janelia-kicad/janelia-kicad-library/README.md

- [Repository Info](#org6b0c83f)
- [Development](#orgdbef2e6)

    <!-- This file is generated automatically from metadata -->
    <!-- File edits may be overwritten! -->

# Repository Info

-   Project Name: janelia-kicad-library
-   Synopsis: Janelia KiCad content library for symbols, footprints, and 3dmodels.
-   Documentation Version: 1.0.0
-   Release Date: 2025-05-16
-   Creation Date: 2023-02-22
-   Kicad Version: 9.0.0
-   License: BSD-3-Clause
-   URL: <https://github.com/janelia-kicad/janelia-kicad-library>
-   Author: Peter Polidoro
-   Email: peter@polidoro.io
-   Copyright: 2025 Howard Hughes Medical Institute
-   References:
    -   [KiCad Library Conventions](https://klc.kicad.org/)

# Development

## Install Guix

[Install Guix](https://guix.gnu.org/manual/en/html_node/Binary-Installation.html)

## Edit metadata.org

    make metadata-edits

## Tangle metadata.org

    make metadata

## Edit project

    make kicad-edits
    exit
