janelia-kicad/janelia-kicad-library/(commit log)

2023-02-22 Add initial symbols and footprints
2023-02-24 Add USB_C connector
2023-02-27 Add OPT101P with various footprints
2023-02-28 Add SMA connector and DIP socket
2023-03-01 Update naming to match KiCad repositories
2023-03-02 Add OPT101 socket
2023-03-07 Add BRIGHT led and photodiode
2023-03-08 Add some capacitors and transimpedence amplifiers
2023-03-10 Add mosfet and capacitor
2023-03-13 Changed resistor values from R_X_PACKAGE to X
2023-03-13 Add optional UMC ground pad
2023-03-15 Add potentiometer and resistors
2023-03-16 Adjust symbols and footprints for wingbeat detector
2023-03-16 Update courtyards for some footprints
2023-03-20 Add back courtyard to MOUNTING_HOLE_2
2023-03-21 Adjust silkscreen text
2023-03-22 Adjust fab layers of footprints
2023-03-23 Adjustments to footprint fab layers
2023-03-30 Add MOUNTING_HOLE_3
2023-03-31 Increase pad size to meet minimum solder paste dimensions
2023-04-03 Add hdmi connector
2023-04-04 Add HDMI_Vertical_SMD schematic symbol
2023-04-04 Add screw term
2023-04-06 Add 20 pin FFC connector
2023-04-13 Modify schematic symbols
2023-04-13 Put voltage in capacitor names
2023-04-13 Add switch debounce IC
2023-04-14 Add resistor footprints and models
2023-04-14 Add 3.3V reg
2023-05-01 Add RS485 driver footprint and 3D model
2023-05-03 Add high current mosfets
2023-05-04 Add high power mosfets
2023-05-05 Add 10uF 35V 0603
2023-05-15 Add FFC 1mm pitch connector
2023-05-18 Add power jack 3D model
2023-05-24 Add Teensy 4.1 step
2023-05-25 Add TEENSY_4.1_FCStd
2023-05-25 Transform Teensy
2023-05-31 Add teensy 4.1 with headers
2023-05-31 Adjust Teensy 4.1 footprint
2023-06-01 Add current supply components
2023-06-05 Add barrel jack connectors
2023-06-06 Rename linear regulators and dc dc converters
2023-06-06 Add linear regulator
2023-06-08 Add pin receptacles
2023-06-08 Update Teensy 4.1 components
2023-06-09 Adjust pin rcpt
2023-06-27 Update arduino-like schematic components
2023-07-13 Add heat sink
2023-07-14 Add heatsink
2023-07-17 Remove pad from footprint
2023-07-18 Rename directories based on KiCad Addons page
2024-02-22 Modify pico
2024-03-19 Add encoder
2024-03-21 Add mosfet
2024-03-22 Adjust TMC5160A-WA and add MOUNTING_HOLE_2.5
2024-03-22 KICAD_USER_DIR -> KICAD_JANELIA_LIBRARY
2024-03-25 Add connectors
2024-03-26 Add screw terminals
2024-03-26 Adjust footprints
2024-03-26 Add screw and push options
2024-04-04 Add molex connectors
2024-04-05 Add power components
2024-04-11 Add capacitors and leds
2024-04-12 Add capacitors and resistors
2024-04-15 Add fan and jst connector
2024-04-16 Add pin header
2024-04-17 Add pico
2024-04-18 Add regulators
2024-04-23 Add capacitor details
2024-04-23 Add polymer capacitor
2024-04-23 Update footprints
2024-04-24 Update diode footprint and 3D model
2024-04-24 Adjust footprints and 3D models
2024-04-25 Add capacitor
2024-04-26 Add mounting hole
2024-04-29 Add standoffs to fan footprint
2024-04-29 Add fan
2024-04-30 Add new connectors
2024-04-30 Add standoff
2024-04-30 Add USB-C connector
2024-05-07 Fix capacitor footprint
2024-05-10 Add LED
2024-05-10 Add LEDs
2024-05-15 Switch resistor to jlcpcb part number
2024-06-13 Add tmc5160-eval board
2024-06-28 Add TMC5130 and some diodes and FFC connector
2024-07-01 Add footprints and 3d models
2024-07-09 Add footprint
2024-07-10 Add pico components
2024-07-12 Add KiCad project
    [janelia-kicad-library.kicad_pcb, janelia-kicad-library.kicad_sch]
2024-07-12 Initial footprint layout
2024-07-13 Update fan
2024-07-13 Remove through hole pads on footprint
2024-07-13 Update text on footprints
2024-07-16 Add and modify some footprints
2024-07-17 Add pico models
    [janelia-kicad-library.kicad_pcb]
2024-07-25 Add capacitor and standoff
2024-07-26 Update footprints from cluster-pcb
2024-07-27 Add mosfet and resistors
2024-08-05 Add phoenix contact screw terminals
2024-08-22 Add 5V 16 MHz xtal
2024-08-26 Add inductor and voltage regulator
2024-08-28 Add speaker and dip switch
2024-08-30 Add speaker and dip switches
2024-09-10 Add high side switch
2024-09-20 Modified footprints
2024-09-23 Add USB connector
2024-09-26 Fix USB slot size
2024-09-27 Add RJ-45 connector
2024-09-27 Adjust solder pads
2024-10-03 Add led driver
2024-10-07 Add DC power connectors
2024-10-07 Adjust footprint
2024-10-08 Add teensy 3D models
2024-10-11 Update Teensy 4.0 model
2024-10-15 Add picoblade connector
2024-10-18 Add IDC connector
2024-10-24 Update footprint
2025-02-17 Add thruster parts
